serenahajjar2003-lang/Project_GroupA2/README.md

# Project_GroupA2
Smart Weather Station
Imane Hojairy 6663
Malak Abou Daher 6569
Mohamad Al Hajjar 6886
Serena Al Hajjar 6885
