serenahajjar2003-lang/Project_GroupA2/Docs/Serena.pdf

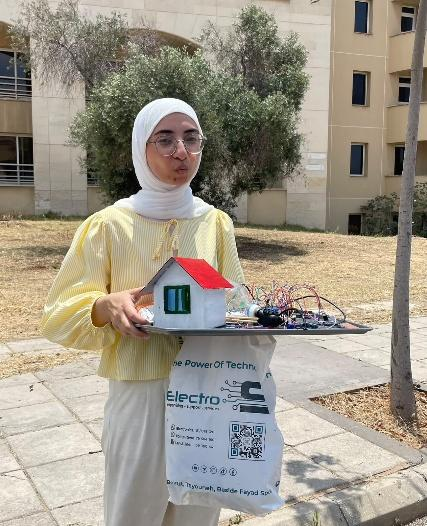
[picture p52: figure]
